lcsribeiro/kit-carrinho/Documentos/img/bottomLayer.png

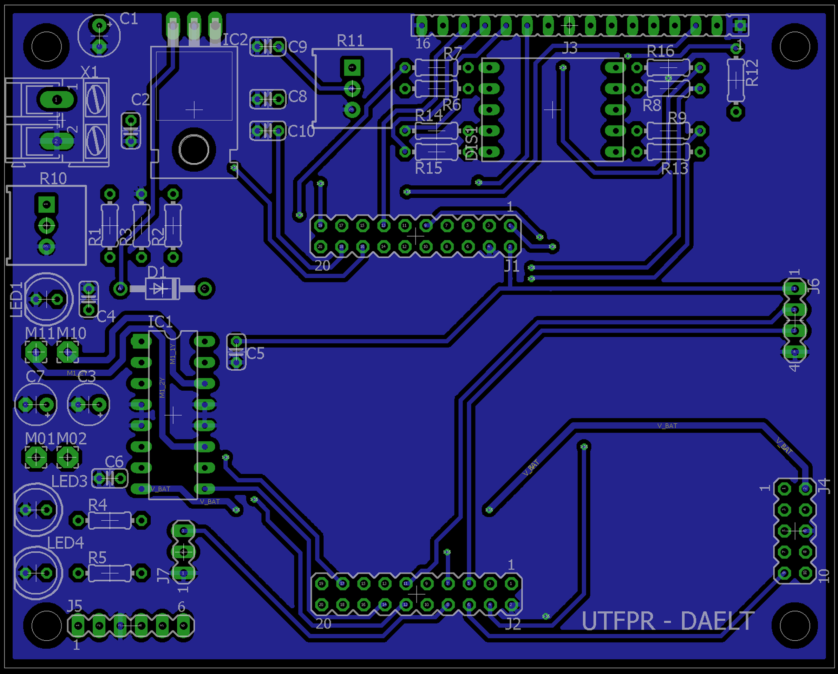
Documentos/img/bottomLayer.png
