lcsribeiro/kit-carrinho/Documentos/img/top-bottomLayer.png

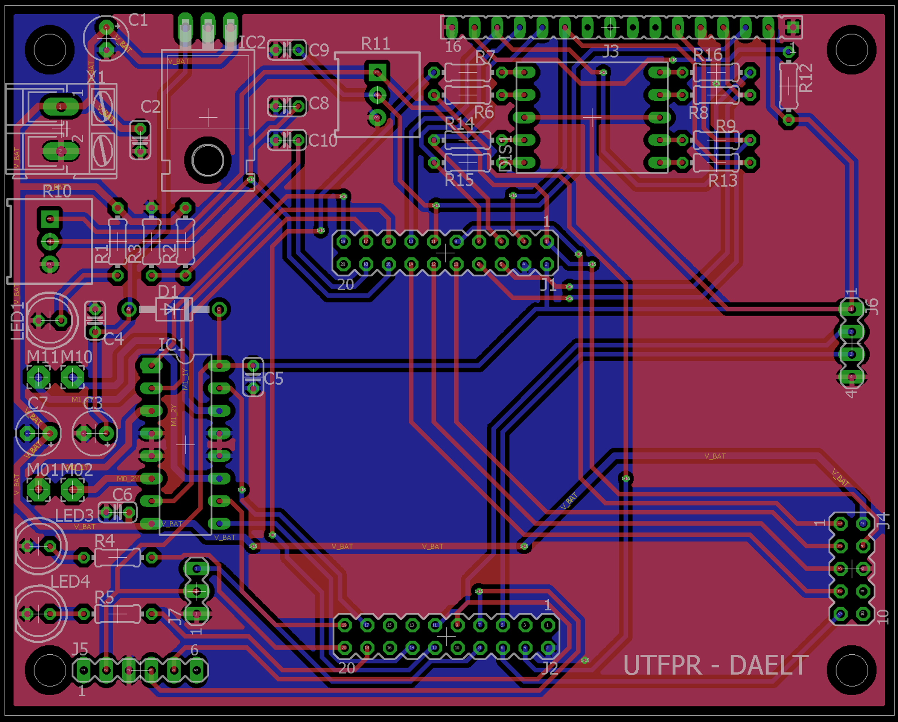
Documentos/img/top-bottomLayer.png
