lcsribeiro/kit-carrinho/Documentos/img/topLayer.png

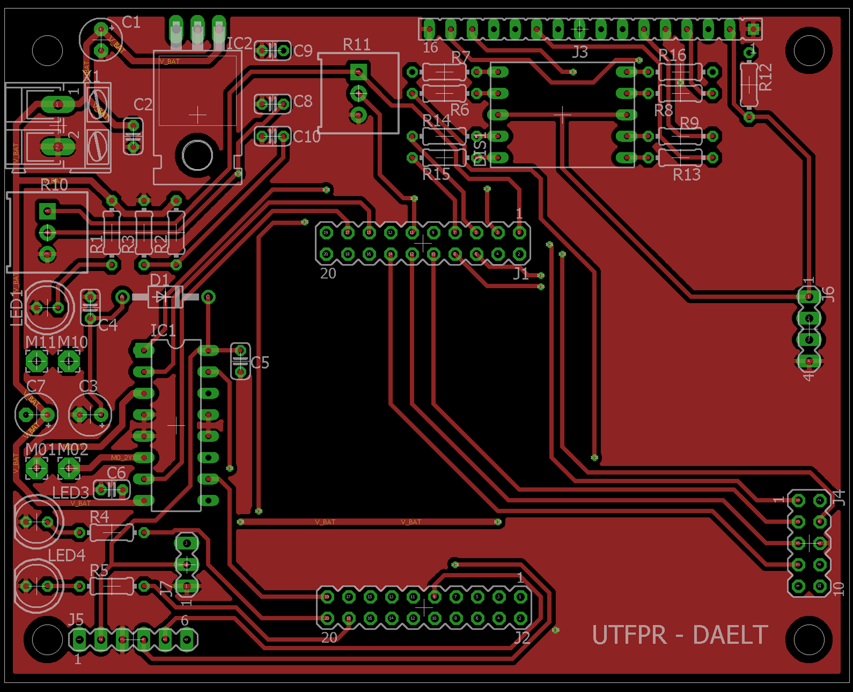
Documentos/img/topLayer.png
