lcsribeiro/kit-carrinho/Shield/Shield-v0/Documentos/Shield-v0.xls

Part | Value | Device | Package | Description
C1 | 10u | CPOL-EUE2.5-5 | E2
C2 | 100n | C-EU025-024X044 | C025-024X044 | CAPACITOR
C3 | 10u | CPOL-EUE2.5-5 | E2
C4 | 100n | C-EU025-024X044 | C025-024X044 | CAPACITOR
C5 | 100n | C-EU025-024X044 | C025-024X044 | CAPACITOR
C6 | 100n | C-EU025-024X044 | C025-024X044 | CAPACITOR
C7 | 10u | CPOL-EUE2.5-5 | E2
C8 | 100n | C-EU025-024X044 | C025-024X044 | CAPACITOR
C9 | 100n | C-EU025-024X044 | C025-024X044 | CAPACITOR
C10 | 100n | C-EU025-024X044 | C025-024X044 | CAPACITOR
D1 | 1N4004 | 1N4004 | DO41-10 | DIODE
DIS1 | HD-H101 | HD-H101 | HDSP-M | LED DISPLAY
IC1 | L293D | L293D | DIL16 | PUSH-PULL 4 CHANNEL DRIVER
IC2 | 78T | 7805T | TO220H | Positive VOLTAGE REGULATOR
J1 |  | MA10-2 | MA10-2 | PIN HEADER
J2 |  | MA10-2 | MA10-2 | PIN HEADER
J3 | FE16-1 | FE16-1 | FE16
J4 |  | MA05-2 | MA05-2 | PIN HEADER
J5 |  | MA06-1 | MA06-1 | PIN HEADER
J6 |  | MA04-1 | MA04-1 | PIN HEADER
J7 |  | MA03-1 | MA03-1 | PIN HEADER
LED1 |  | LED5MM | LED5MM | LED
LED3 |  | LED5MM | LED5MM | LED
LED4 |  | LED5MM | LED5MM | LED
M01 |  | 2
M02 |  | 2
M10 |  | 2
M11 |  | 2
R1 | 1k | R-EU_0204/7 | 0204/7 | RESISTOR
R2 | 10k | R-EU_0204/7 | 0204/7 | RESISTOR
R3 | 5.6k | R-EU_0204/7 | 0204/7 | RESISTOR
R4 | 560 | R-EU_0204/7 | 0204/7 | RESISTOR
R5 | 560 | R-EU_0204/7 | 0204/7 | RESISTOR
R6 | 560 | R-EU_0204/7 | 0204/7 | RESISTOR
R7 | 560 | R-EU_0204/7 | 0204/7 | RESISTOR
R8 | 560 | R-EU_0204/7 | 0204/7 | RESISTOR
R9 | 560 | R-EU_0204/7 | 0204/7 | RESISTOR
R10 | 10k | TRIMPOT-PTH-10MM-KNOB-1/2W-10% | TRIMPOT-PTH-3386U | Trimming Potentiometer (Trimpot)
R11 | 10k | TRIMPOT-PTH-10MM-KNOB-1/2W-10% | TRIMPOT-PTH-3386U | Trimming Potentiometer (Trimpot)
R12 | 33R | R-EU_0204/7 | 0204/7 | RESISTOR
R13 | 560 | R-EU_0204/7 | 0204/7 | RESISTOR
R14 | 560 | R-EU_0204/7 | 0204/7 | RESISTOR
R15 | 560 | R-EU_0204/7 | 0204/7 | RESISTOR
R16 | 560 | R-EU_0204/7 | 0204/7 | RESISTOR
X1 |  | AK300/2 | AK300/2 | CONNECTOR
