lcsribeiro/kit-carrinho/Chassi/CNC.dxf

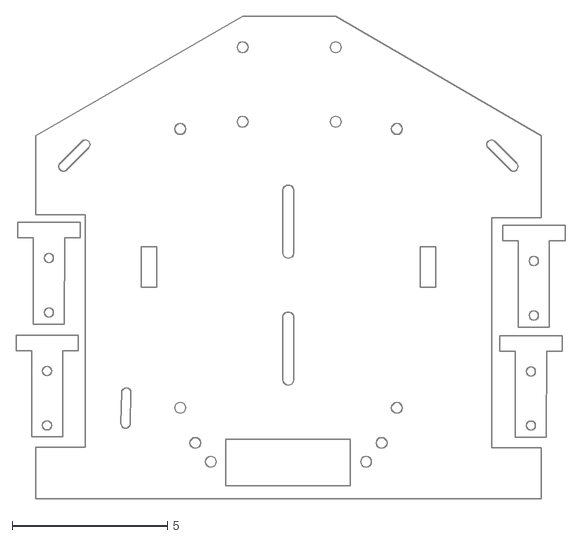
[picture p4: CAD file, 2017-11-04]
Chassi/CNC.dxf
17.7 x 15.5
