lcsribeiro/kit-carrinho/(list of files, cad)

Other CAD files:
Chassi/chassi.dwg
