lcsribeiro/kit-carrinho/Documentos/Sensor_de_linha.pdf

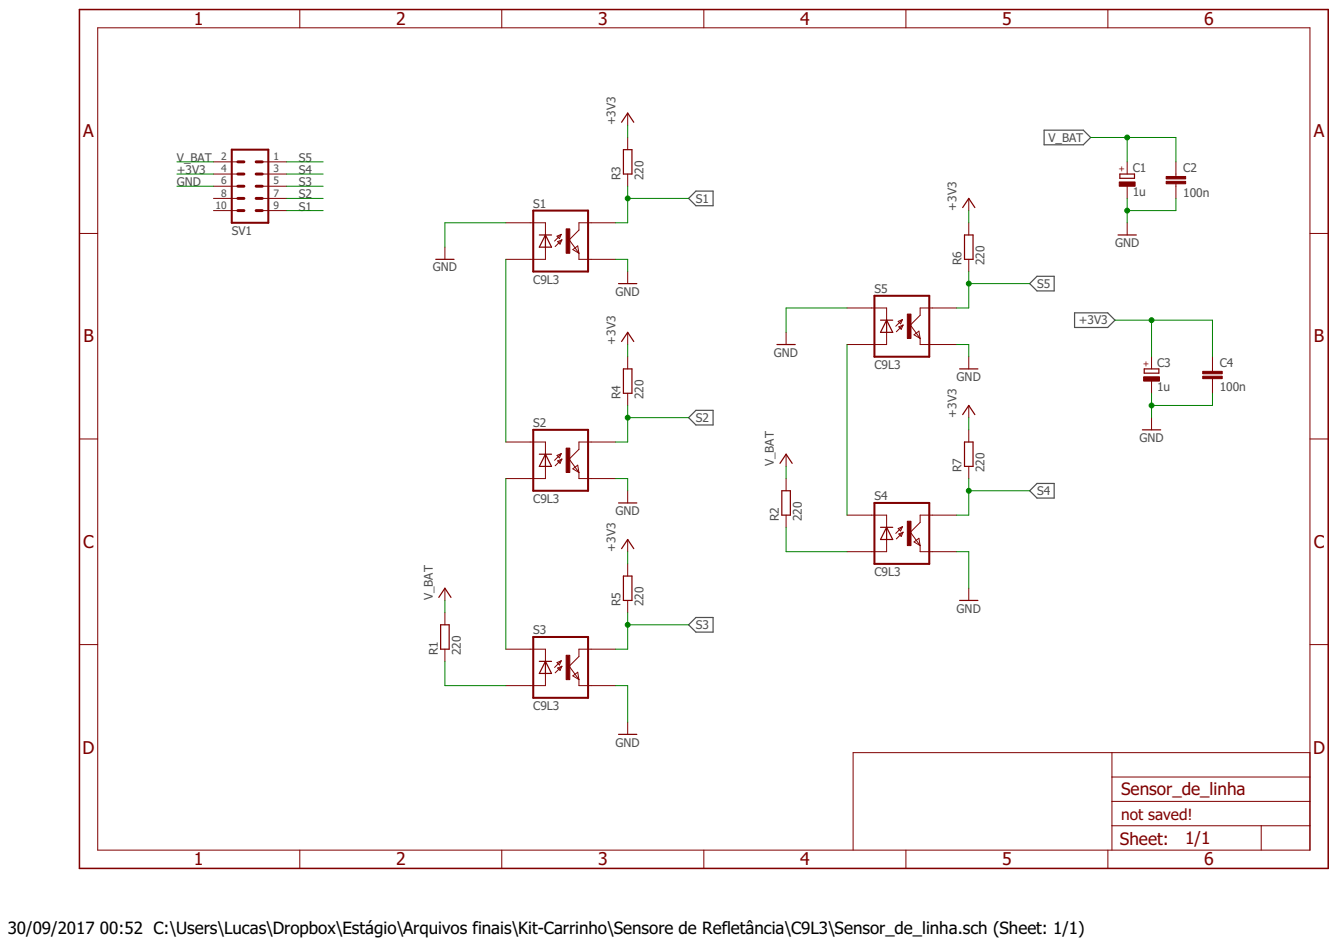
[picture p5: page 1]

30/09/2017 00:52 C:\Users\Lucas\Dropbox\Estágio\Arquivos finais\Kit-Carrinho\Sensore de Refletância\C9L3\Sensor_de_linha.sch (Sheet: 1/1)
