lcsribeiro/kit-carrinho/Chassi/CHASSI.pdf

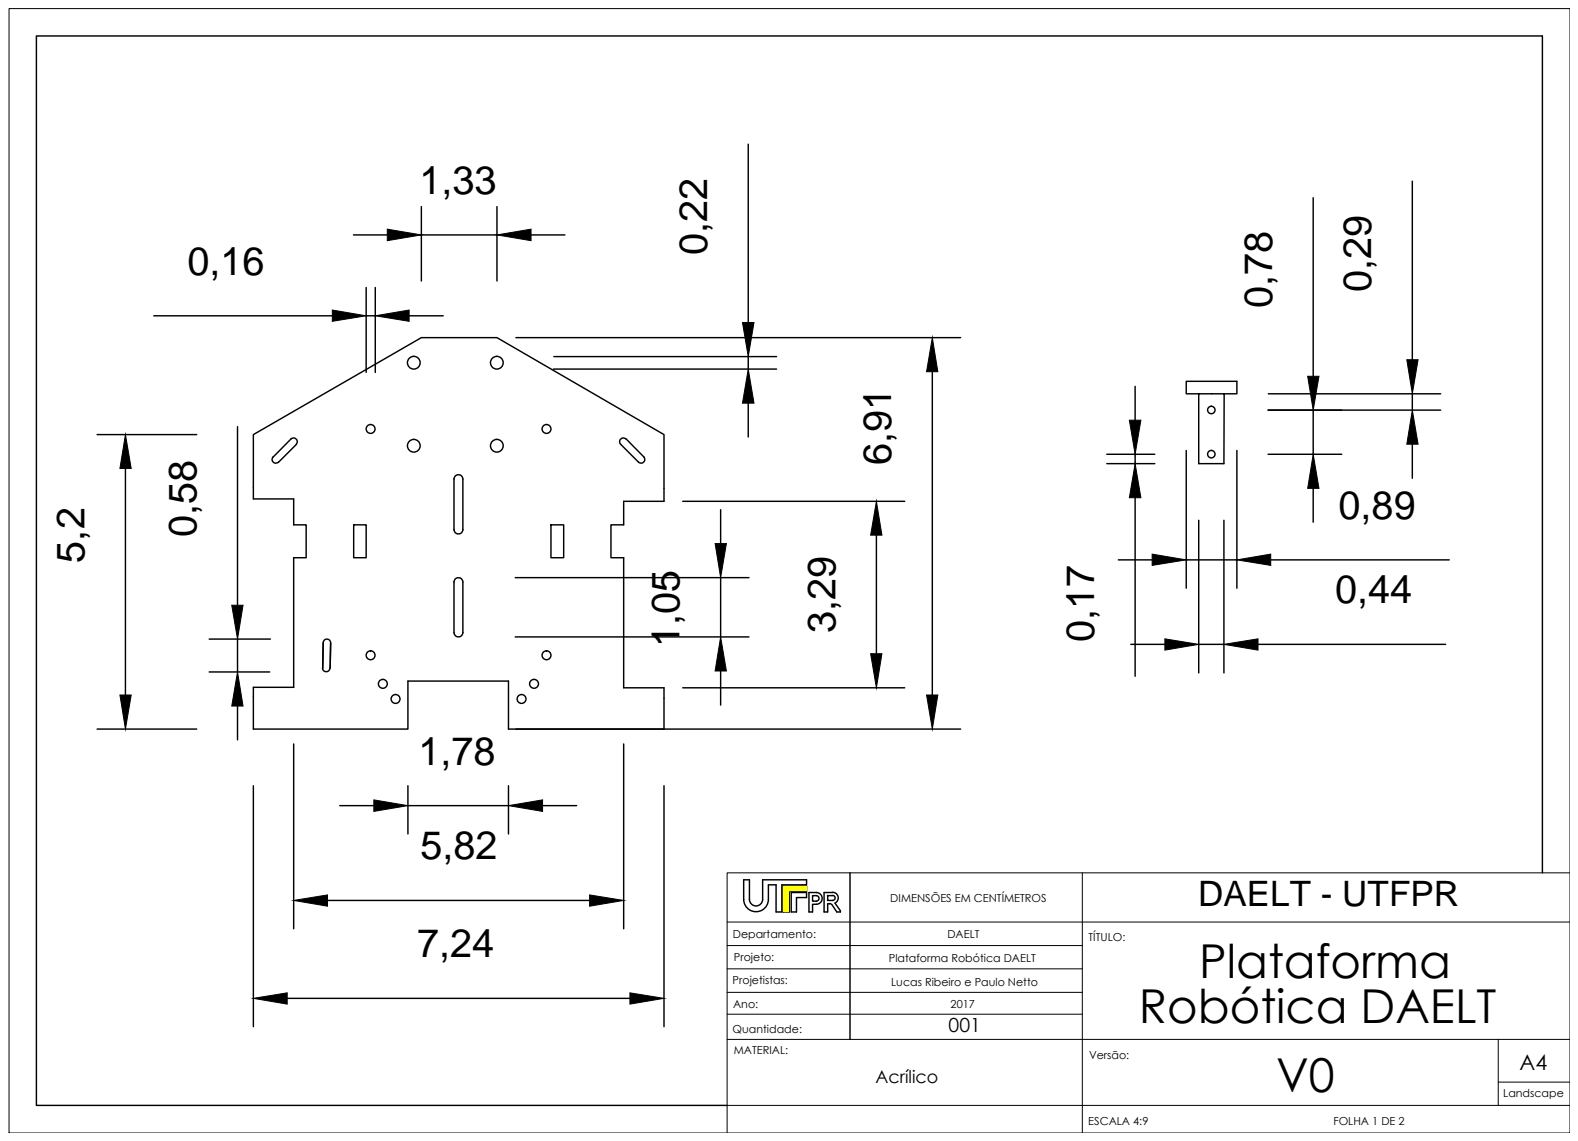
[picture p6: page 1]

Departamento:

Projeto:
