lcsribeiro/kit-carrinho/Documentos/Shield-v0.pdf

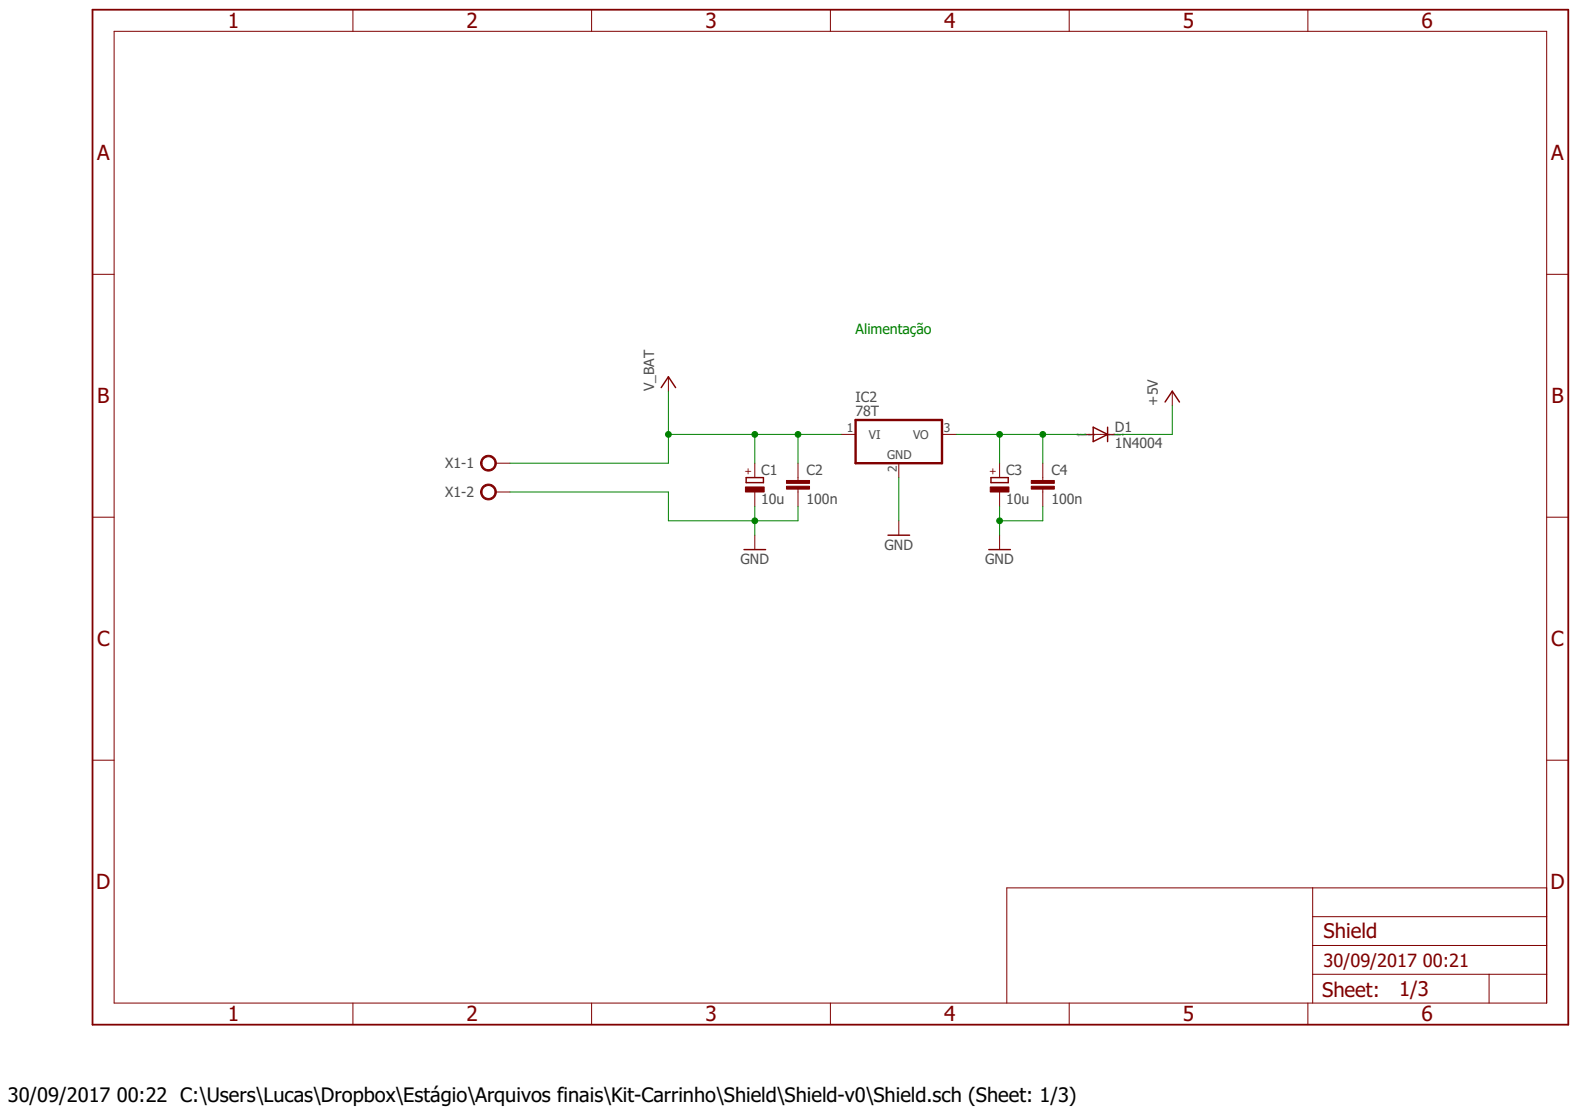
[picture p8: page 1]

30/09/2017 00:22 C:\Users\Lucas\Dropbox\Estágio\Arquivos finais\Kit-Carrinho\Shield\Shield-v0\Shield.sch (Sheet: 1/3)

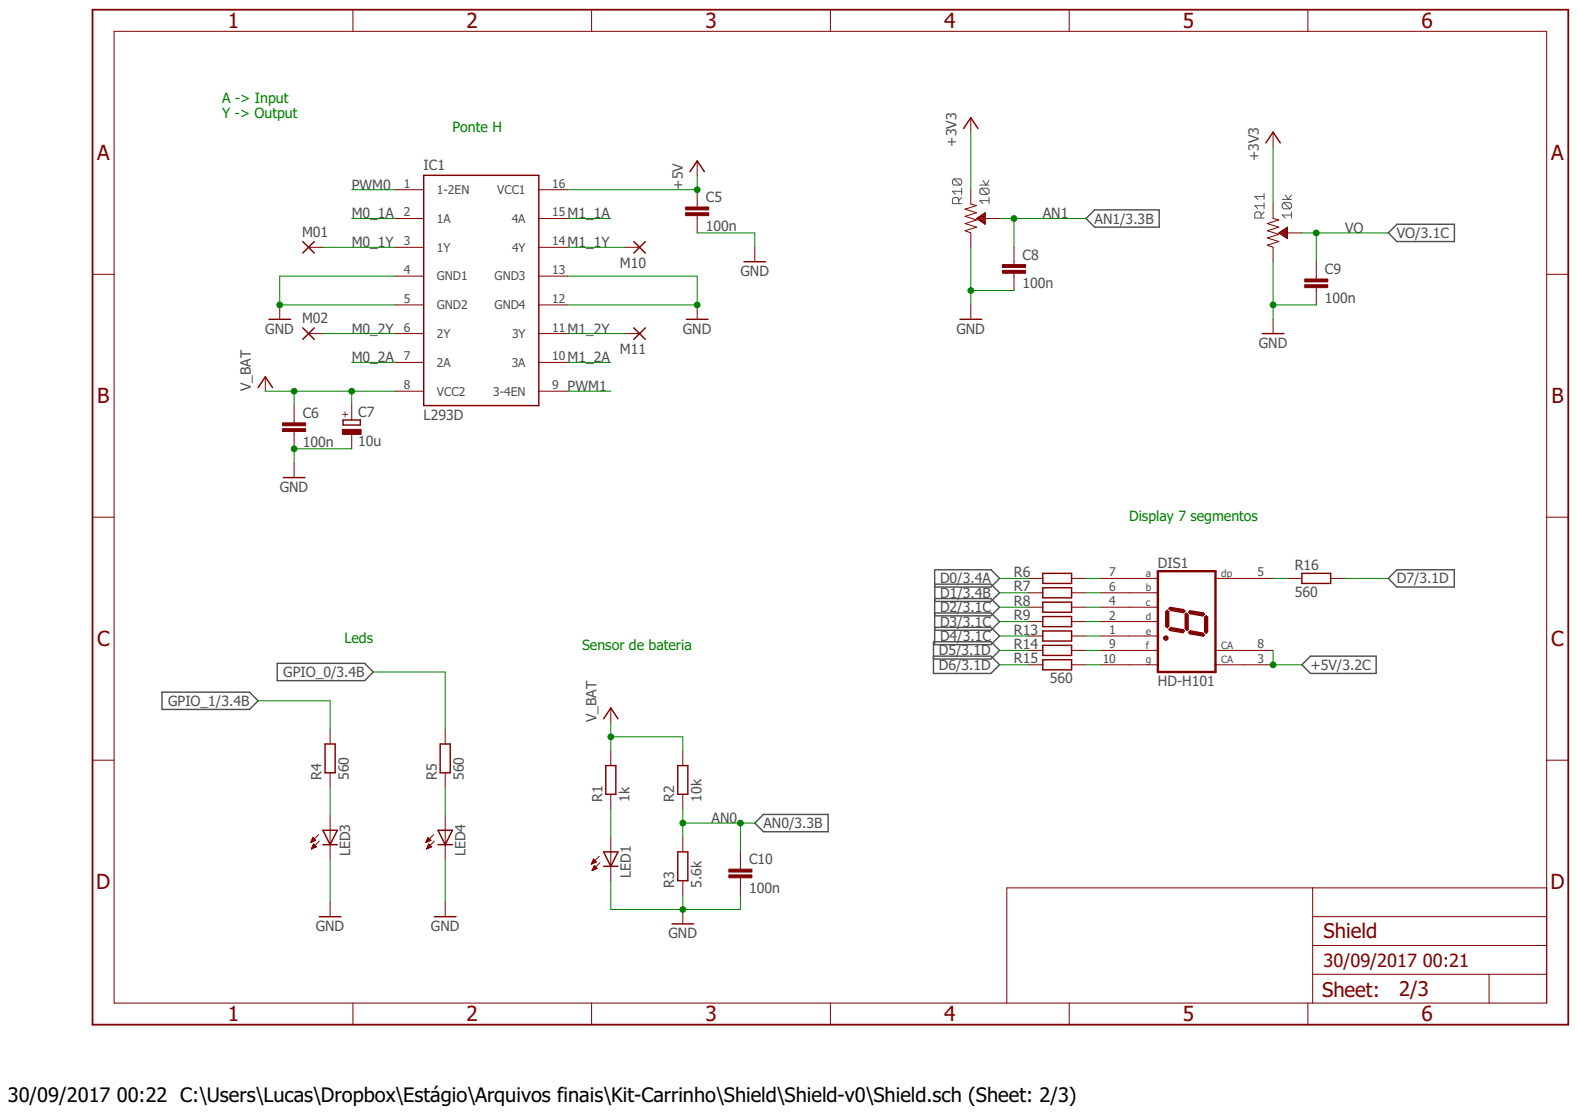
[picture p9: page 2]

30/09/2017 00:22 C:\Users\Lucas\Dropbox\Estágio\Arquivos finais\Kit-Carrinho\Shield\Shield-v0\Shield.sch (Sheet: 2/3)

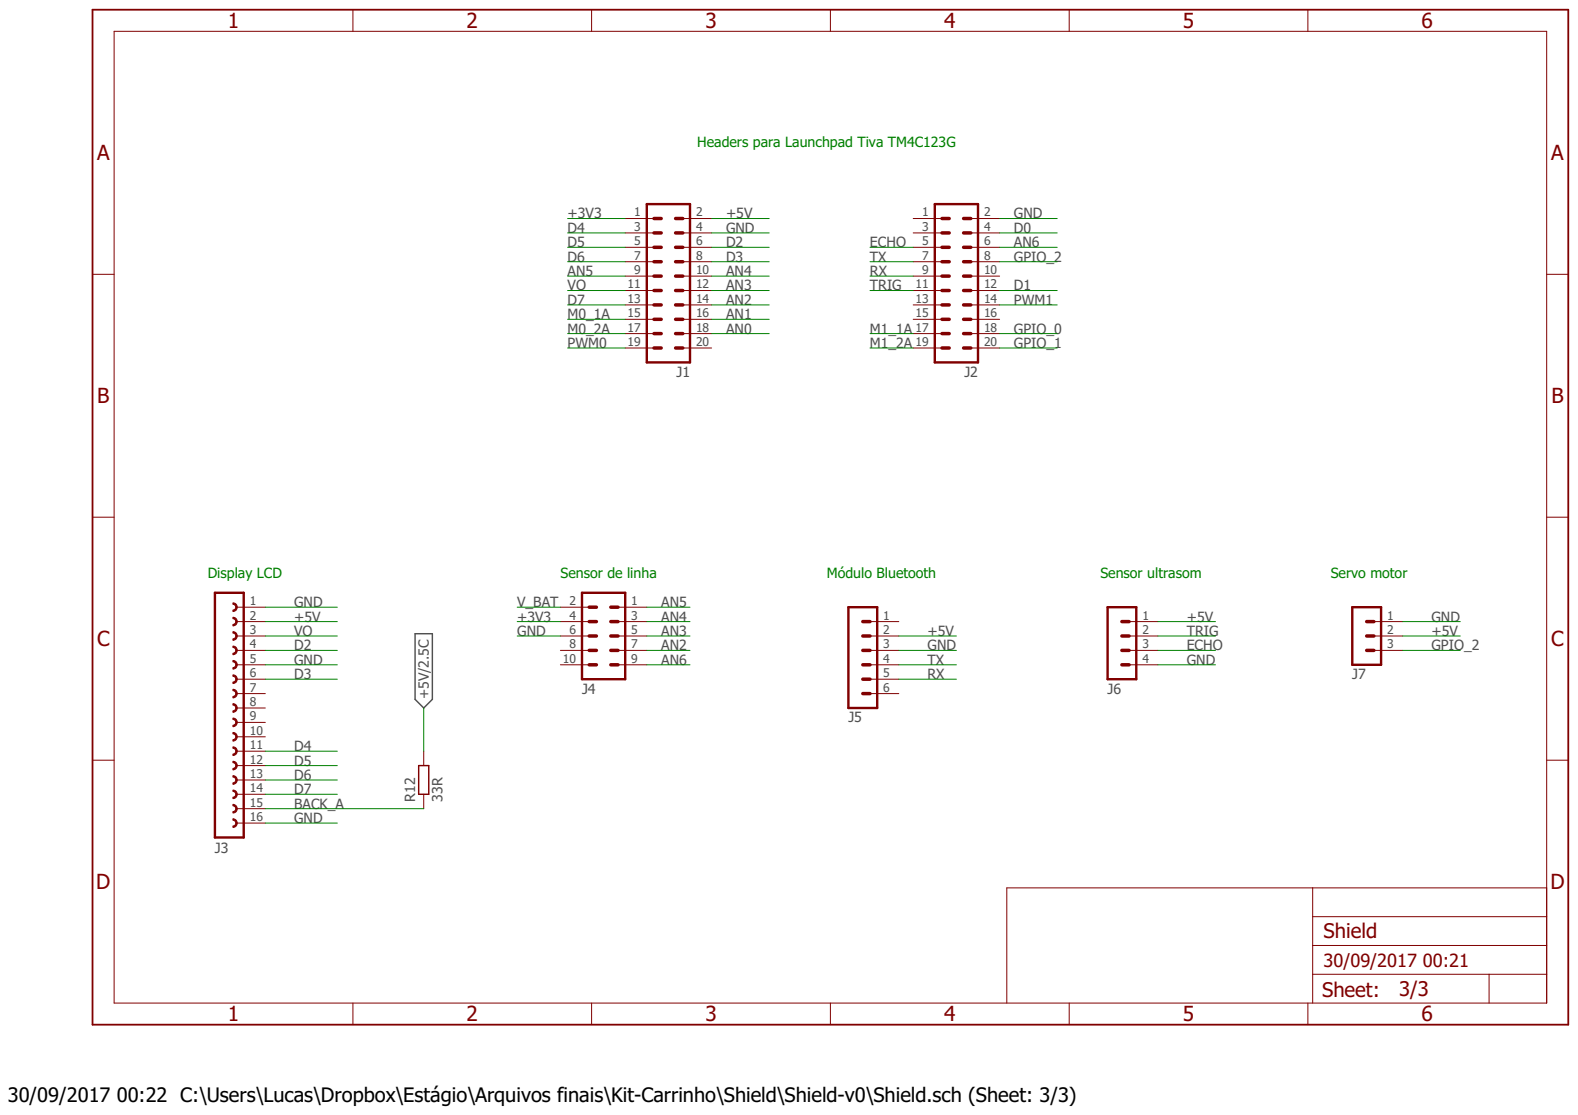
[picture p10: page 3]

Headers para Launchpad Tiva TM4C123G

30/09/2017 00:22 C:\Users\Lucas\Dropbox\Estágio\Arquivos finais\Kit-Carrinho\Shield\Shield-v0\Shield.sch (Sheet: 3/3)
