lcsribeiro/kit-carrinho/Shield/Shield-v0/Eagle/Shield.brd

## EAGLE design Shield/Shield-v0/Eagle/Shield.brd (2017-11-04)

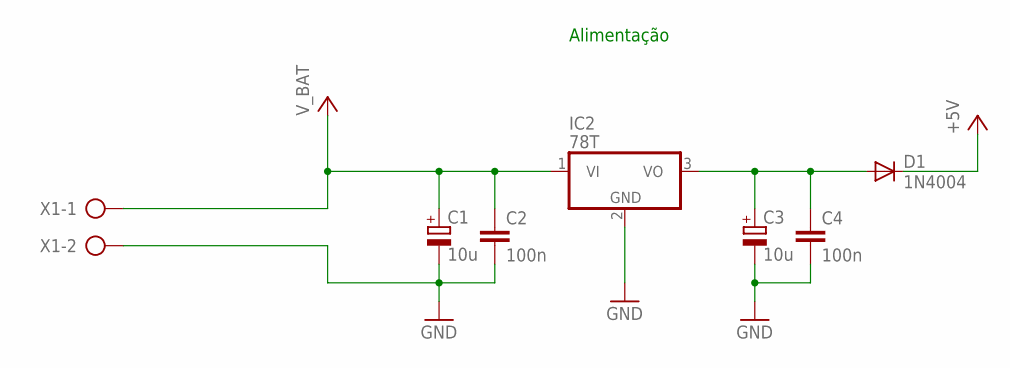
[picture p11: schematic Shield.sch, sheet 1]

Parts:
C1, C3: 10u; E2,5-5
C2, C4: 100n; C025-024X044
D1: 1N4004; DO41-10
IC2: 78T; TO220H
X1: AK300/2

Connections:
+5: C3.+, C4.1, D1.A, IC2.3 (VO)
+5V: D1.C; also elsewhere on the board
GND: C1.-, C2.2, C3.-, C4.2, IC2.2 (GND), X1.2; also elsewhere on the board
V_BAT: C1.+, C2.1, IC2.1 (VI), X1.1; also elsewhere on the board

Notes on the sheet:
Alimentação

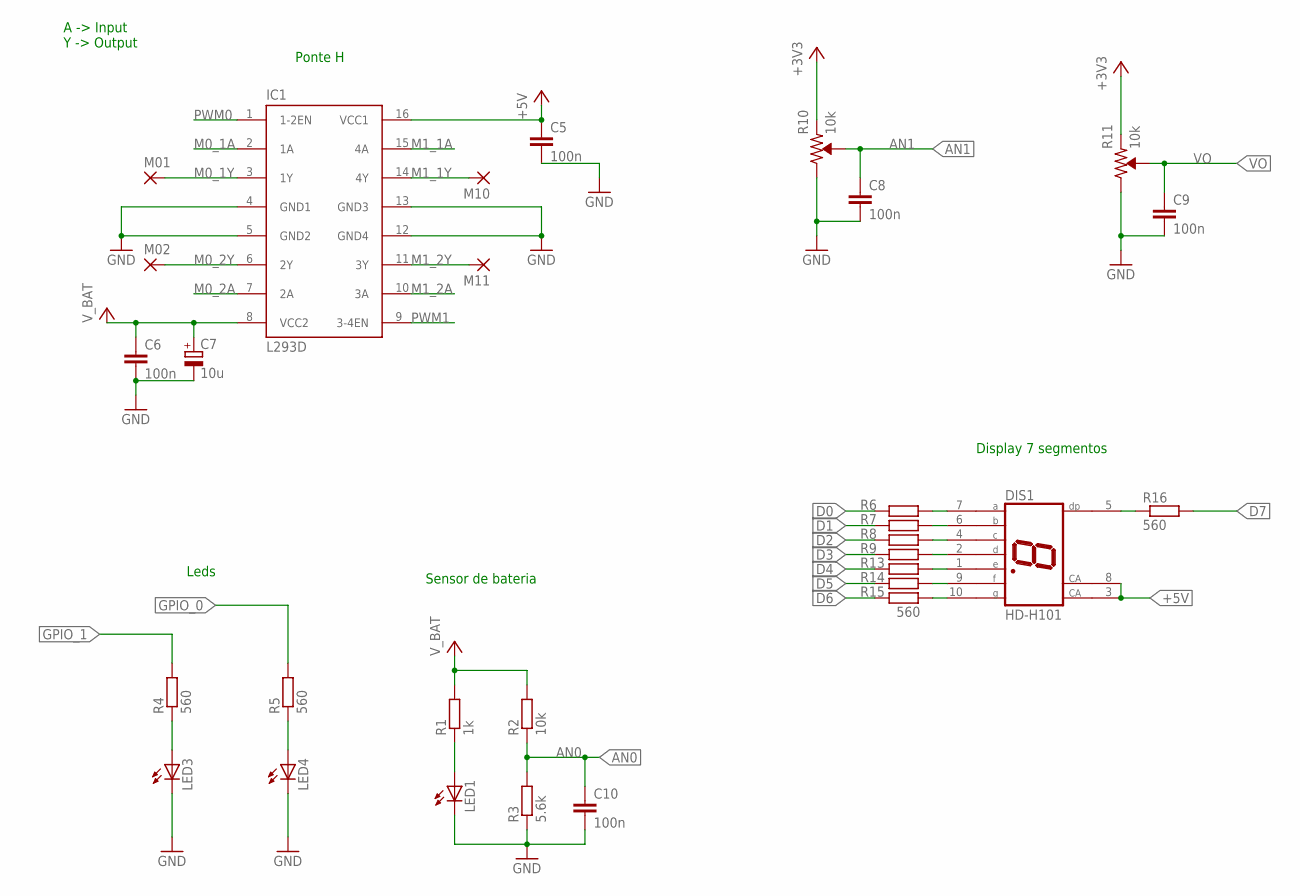
[picture p12: schematic Shield.sch, sheet 2]

Parts:
C5, C6, C8, C9, C10: 100n; C025-024X044
C7: 10u; E2,5-5
DIS1: HD-H101; HDSP-M
IC1: L293D; DIL16
LED1, LED3, LED4: LED5MM
M01, M02, M10, M11: 2,54/1,1
R1: 1k; 0204/7
R2: 10k; 0204/7
R3: 5.6k; 0204/7
R4, R5, R6, R7, R8, R9, R13, R14, R15, R16: 560; 0204/7
R10, R11: 10k; TRIMPOT-PTH-3386U

Connections:
+3V3: R10.1 (CCW), R11.1 (CCW); also elsewhere on the board
+5V: C5.1, DIS1.3 (CA), DIS1.8 (CA), IC1.16 (VCC1); also elsewhere on the board
AN0: C10.1, R2.1, R3.2; also elsewhere on the board
AN1: C8.1, R10.2 (WIPER); also elsewhere on the board
D0: R6.1; also elsewhere on the board
D1: R7.1; also elsewhere on the board
D2: R8.1; also elsewhere on the board
D3: R9.1; also elsewhere on the board
D4: R13.1; also elsewhere on the board
D5: R14.1; also elsewhere on the board
D6: R15.1; also elsewhere on the board
D7: R16.2; also elsewhere on the board
GND: C5.2, C6.2, C7.-, C8.2, C9.2, C10.2, IC1.4 (GND1), IC1.5 (GND2), IC1.12 (GND4), IC1.13 (GND3), LED1.K (C), LED3.K (C), LED4.K (C), R3.1, R10.3 (CW), R11.3 (CW); also elsewhere on the board
GPIO_0: R5.2; also elsewhere on the board
GPIO_1: R4.2; also elsewhere on the board
M0_1A: IC1.2 (1A); also elsewhere on the board
M0_1Y: IC1.3 (1Y), M01.1
M0_2A: IC1.7 (2A); also elsewhere on the board
M0_2Y: IC1.6 (2Y), M02.1
M1_1A: IC1.15 (4A); also elsewhere on the board
M1_1Y: IC1.14 (4Y), M10.1
M1_2A: IC1.10 (3A); also elsewhere on the board
M1_2Y: IC1.11 (3Y), M11.1
unnamed: DIS1.7 (A), R6.2
unnamed: LED1.A, R1.1
unnamed: DIS1.6 (B), R7.2
unnamed: DIS1.4 (C), R8.2
unnamed: DIS1.2 (D), R9.2
unnamed: DIS1.1 (E), R13.2
unnamed: DIS1.9 (F), R14.2
unnamed: DIS1.10 (G), R15.2
unnamed: DIS1.5 (DP), R16.1
unnamed: LED3.A, R4.1
unnamed: LED4.A, R5.1
PWM0: IC1.1 (1-2EN); also elsewhere on the board
PWM1: IC1.9 (3-4EN); also elsewhere on the board
VO: C9.1, R11.2 (WIPER); also elsewhere on the board
V_BAT: C6.1, C7.+, IC1.8 (VCC2), R1.2, R2.2; also elsewhere on the board

Notes on the sheet:
A -> Input Y -> Output
Ponte H
Sensor de bateria
Leds
Display 7 segmentos

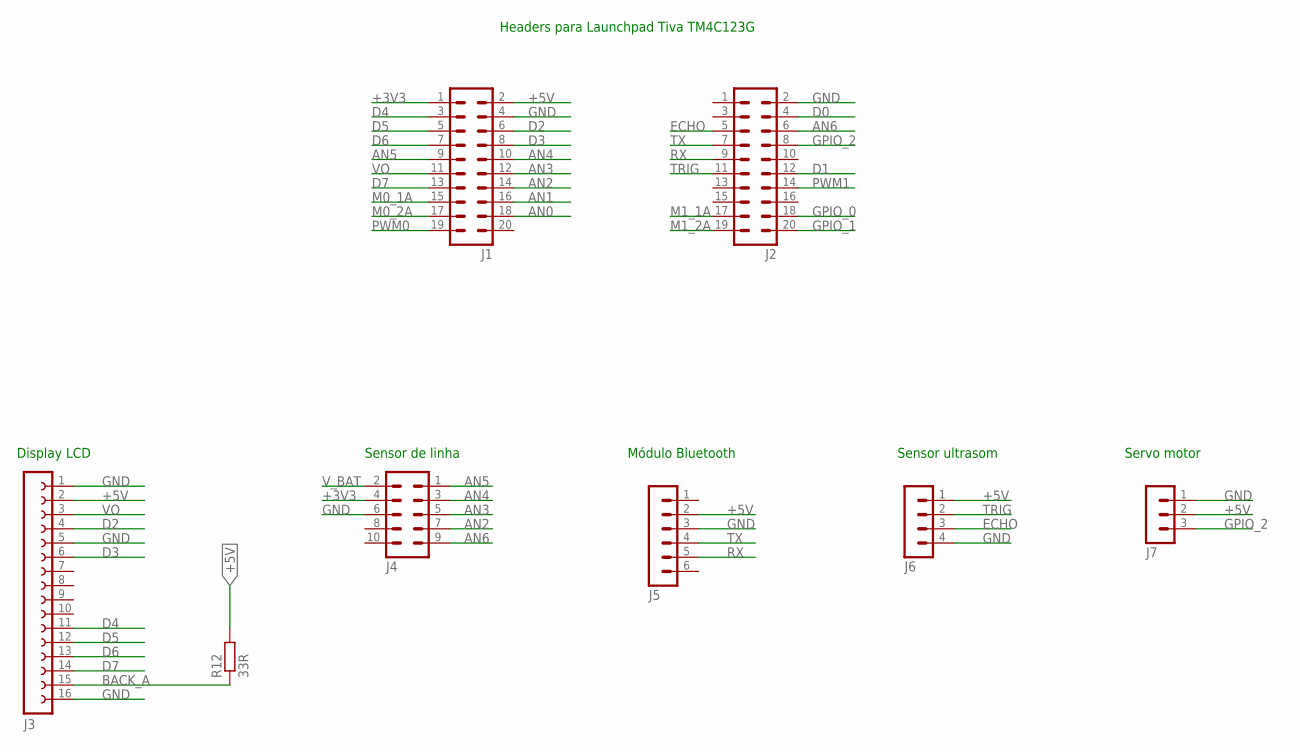
[picture p13: schematic Shield.sch, sheet 3]

Parts:
J1, J2: MA10-2
J3: FE16-1; FE16
J4: MA05-2
J5: MA06-1
J6: MA04-1
J7: MA03-1
R12: 33R; 0204/7

Connections:
+3V3: J1.1, J4.4; also elsewhere on the board
+5V: J1.2, J3.2, J5.2, J6.1, J7.2, R12.2; also elsewhere on the board
AN0: J1.18; also elsewhere on the board
AN1: J1.16; also elsewhere on the board
AN2: J1.14, J4.7
AN3: J1.12, J4.5
AN4: J1.10, J4.3
AN5: J1.9, J4.1
AN6: J2.6, J4.9
BACK_A: J3.15, R12.1
D0: J2.4; also elsewhere on the board
D1: J2.12; also elsewhere on the board
D2: J1.6, J3.4; also elsewhere on the board
D3: J1.8, J3.6; also elsewhere on the board
D4: J1.3, J3.11; also elsewhere on the board
D5: J1.5, J3.12; also elsewhere on the board
D6: J1.7, J3.13; also elsewhere on the board
D7: J1.13, J3.14; also elsewhere on the board
ECHO: J2.5, J6.3
GND: J1.4, J2.2, J3.1, J3.5, J3.16, J4.6, J5.3, J6.4, J7.1; also elsewhere on the board
GPIO_0: J2.18; also elsewhere on the board
GPIO_1: J2.20; also elsewhere on the board
GPIO_2: J2.8, J7.3
M0_1A: J1.15; also elsewhere on the board
M0_2A: J1.17; also elsewhere on the board
M1_1A: J2.17; also elsewhere on the board
M1_2A: J2.19; also elsewhere on the board
PWM0: J1.19; also elsewhere on the board
PWM1: J2.14; also elsewhere on the board
RX: J2.9, J5.5
TRIG: J2.11, J6.2
TX: J2.7, J5.4
VO: J1.11, J3.3; also elsewhere on the board
V_BAT: J4.2; also elsewhere on the board

Notes on the sheet:
Sensor ultrasom
Módulo Bluetooth
Sensor de linha
Servo motor
Headers para Launchpad Tiva TM4C123G
Display LCD

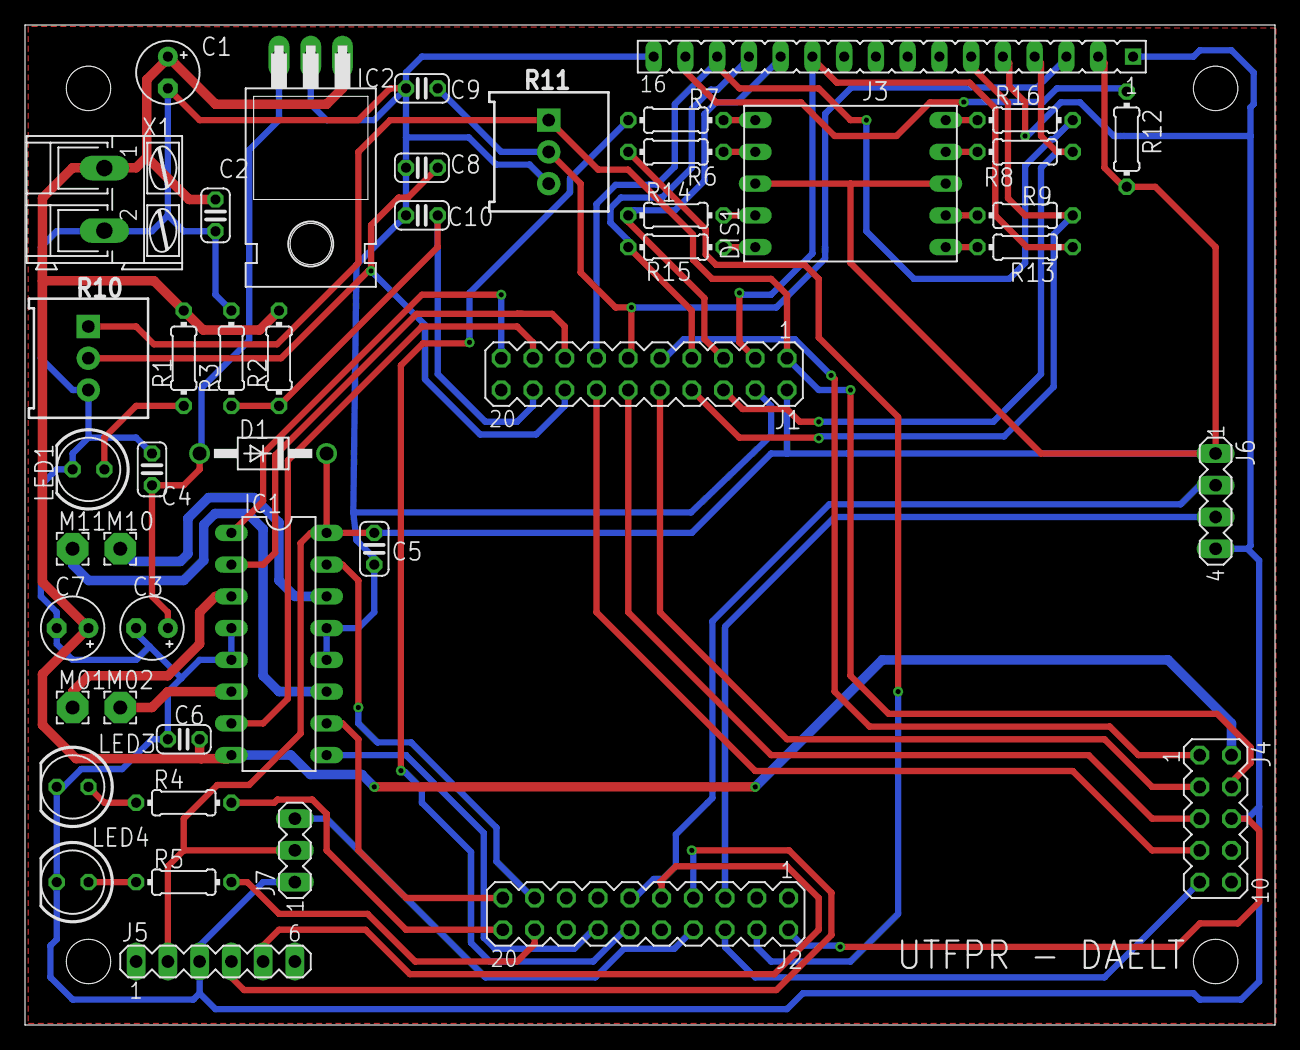
[picture p14: board Shield.brd from above]

Board: 2 copper layers, 100.0 x 80.0 mm, 45 parts (0 on the bottom side), 50 nets.
