lcsribeiro/kit-carrinho/Sensore de Refletância/C9L3/Eagle/Sensor_de_linha.brd

## EAGLE design Sensore de Refletância/C9L3/Eagle/Sensor_de_linha.brd (2017-11-04)

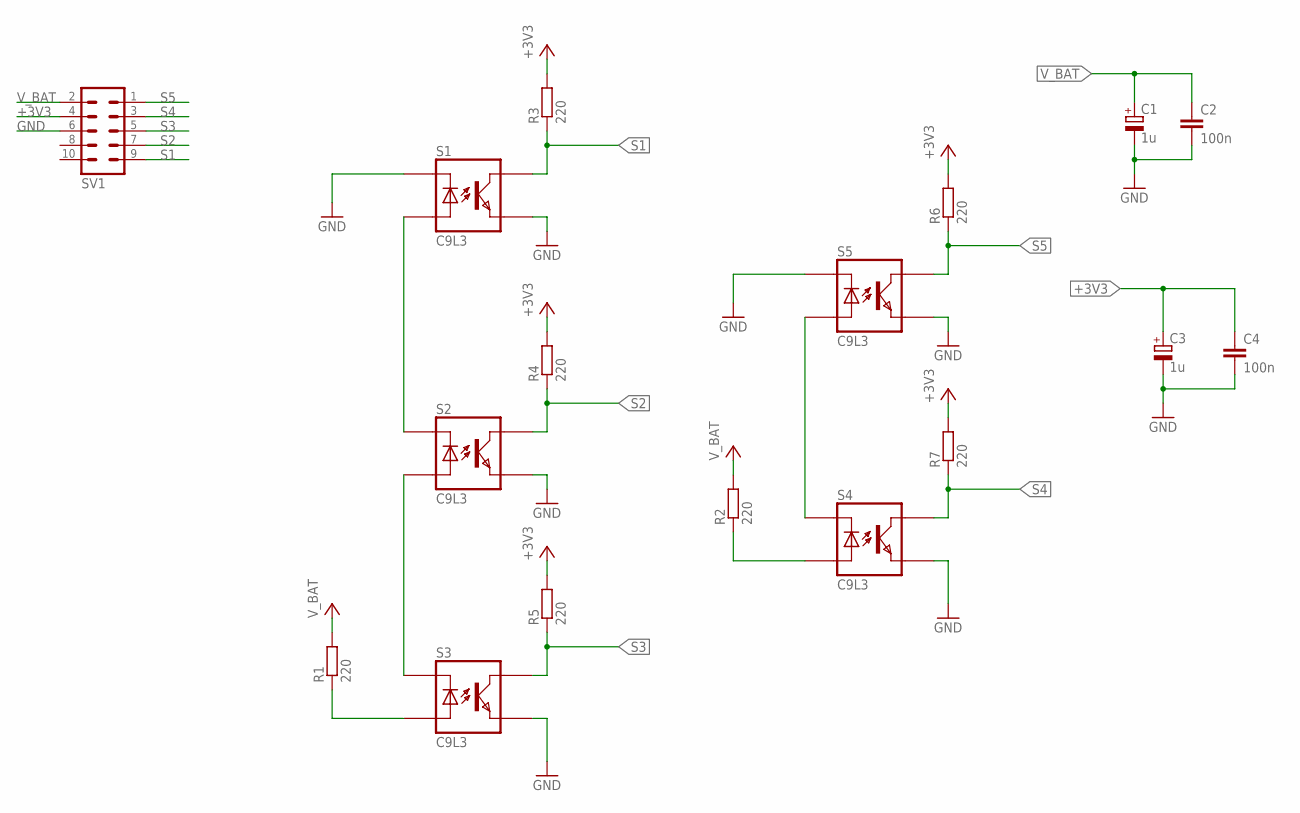
[picture p15: schematic Sensor_de_linha.sch]

Parts:
C1, C3: 1u; E5-5
C2, C4: 100n; C025-030X050
R1, R2, R3, R4, R5, R6, R7: 220; 0204/7
S1, S2, S3, S4, S5: C9L3
SV1: MA05-2

Connections:
+3V3: C3.+, C4.1, R3.2, R4.2, R5.2, R6.2, R7.2, SV1.4
GND: C1.-, C2.2, C3.-, C4.2, S1.2, S1.4, S2.2, S3.2, S4.2, S5.2, S5.4, SV1.6
unnamed: R2.1, S4.1
unnamed: S2.1, S3.4
unnamed: S1.1, S2.4
unnamed: R1.1, S3.1
unnamed: S4.4, S5.1
S1: R3.1, S1.3, SV1.9
S2: R4.1, S2.3, SV1.7
S3: R5.1, S3.3, SV1.5
S4: R7.1, S4.3, SV1.3
S5: R6.1, S5.3, SV1.1
V_BAT: C1.+, C2.1, R1.2, R2.2, SV1.2

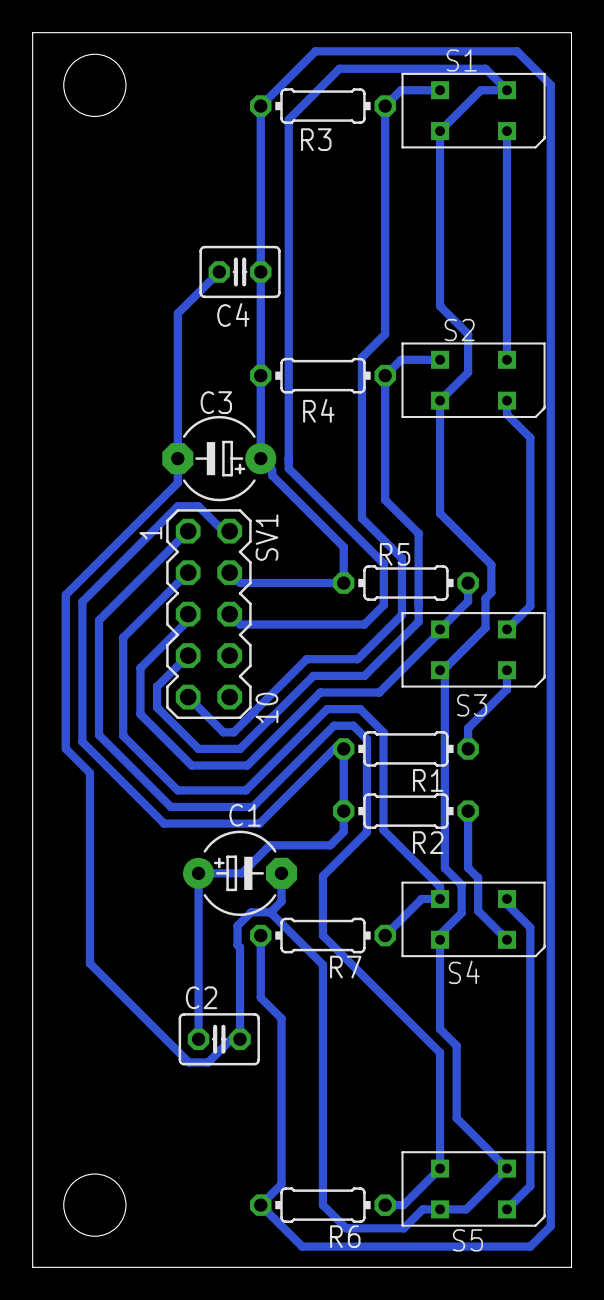
[picture p16: board Sensor_de_linha.brd from above]

Board: 2 copper layers, 33.0 x 75.6 mm, 17 parts (0 on the bottom side), 13 nets.
